SundayRosin/RunGenerator/README.md

<h1 align="center">Блок управления бензиновым генератором «Дозор», версия ПО 1.0.</h1>

<h2>Краткое описание.</h2>
<p align="left">
Блок управления предназначен для автоматического запуска генератора, в случае пропадания напряжения в городской сети.
</p>
<p>
Проект был разработан в 2021 году.
</p>
<p>
<a href="./Docs/Boards/Boards.md">Описание плат</a><br>
</p>
<p>
<a href="./Boards">Шаблоны плат (файлы sprint-layout 6)</a>
</p>
<p>
<a href="./Docs/Инструкция.docx">Инструкция и описание работы (Word file, 12 страниц)</a>
</p>
<p>
<a href="./Docs/LoadFirmware/LoadFirmware.md">Как прошить.</a>
</p>

<p align="left">
Устройство состоит из:<br>
-Плата «Blue Pill» с микроконтроллером  STM32F103C8T6.  Для быстрого обновления управляющей программы, микроконтроллер прошит загрузчиком arduino stm32 bootloader.  Написана программа, позволяющая удаленно обновлять прошивку (без наличия средств разработки).<br>
-Плата периферии. Содержит элементы управления и выходные каскады.
</p>
<p>
Программа для микроконтроллера написана на языке C, в среде разработки Keil uVision5.
</p>
<p>
 
</p>

Инструкция находиться в папке Firmware/Doc.<br>
Так же написанна программа FirmwareUpdater на Qt для удаленной прошивки устройства.
</p>
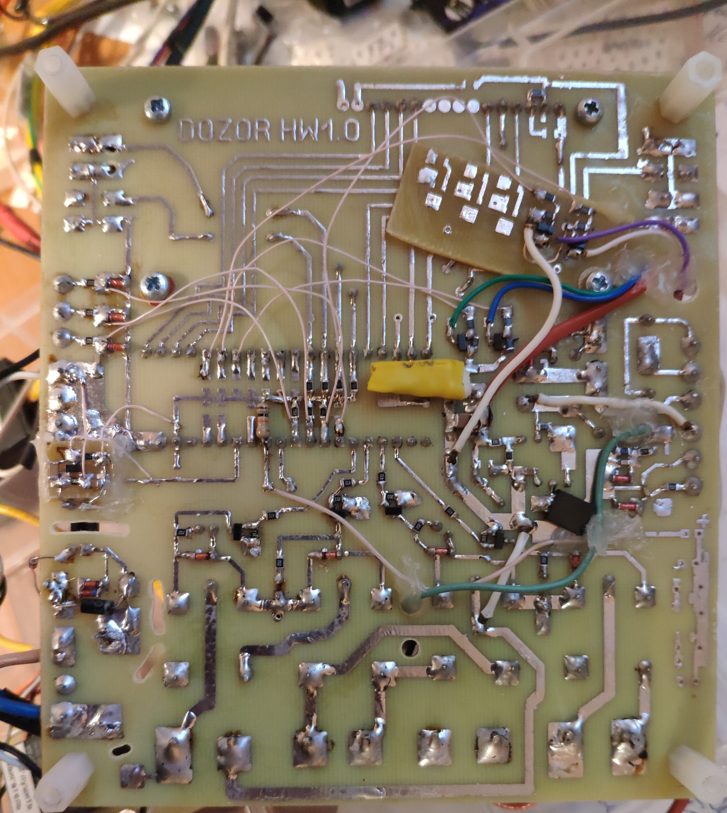
[picture p1: Фото устройства/IMG_20210401_210557.jpg]

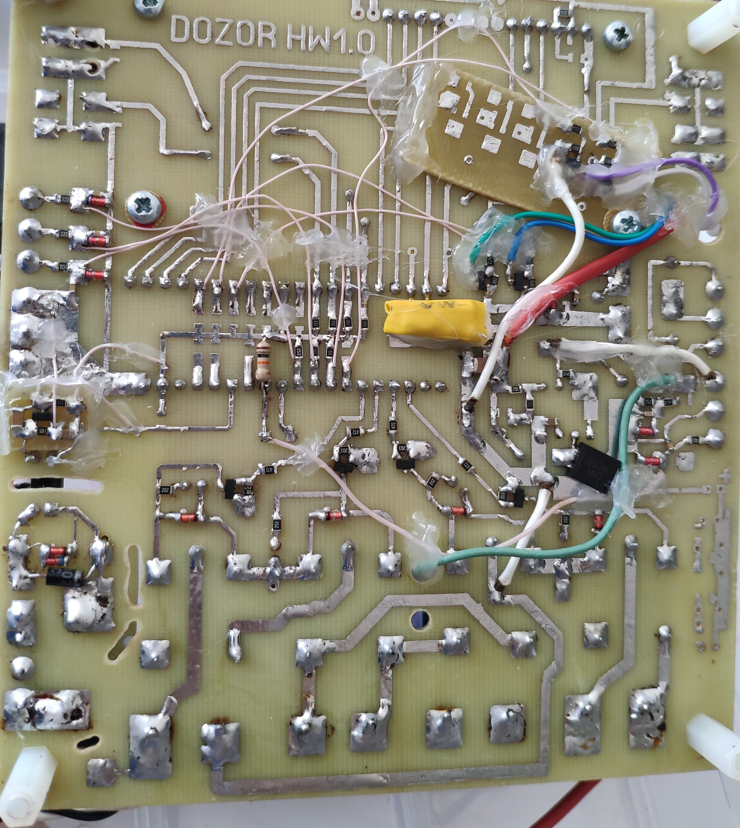
[picture p2: Фото устройства/IMG_20210402_081232.jpg]

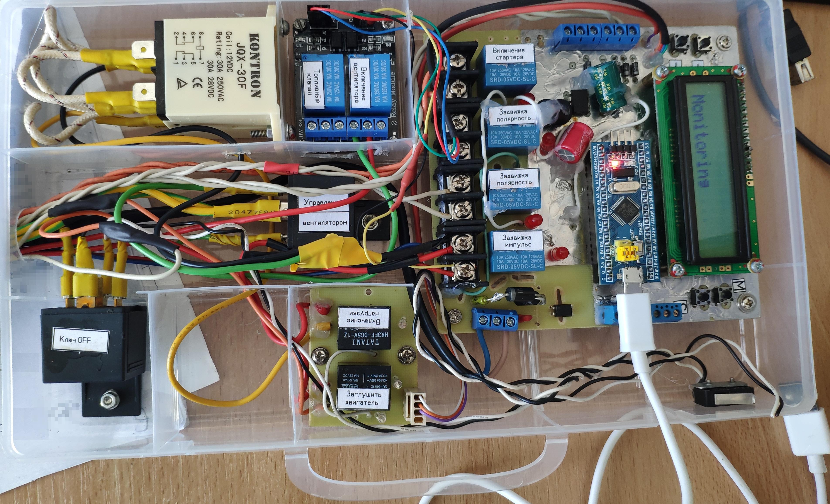
[picture p3: Фото устройства/IMG_20210402_120038.jpg]

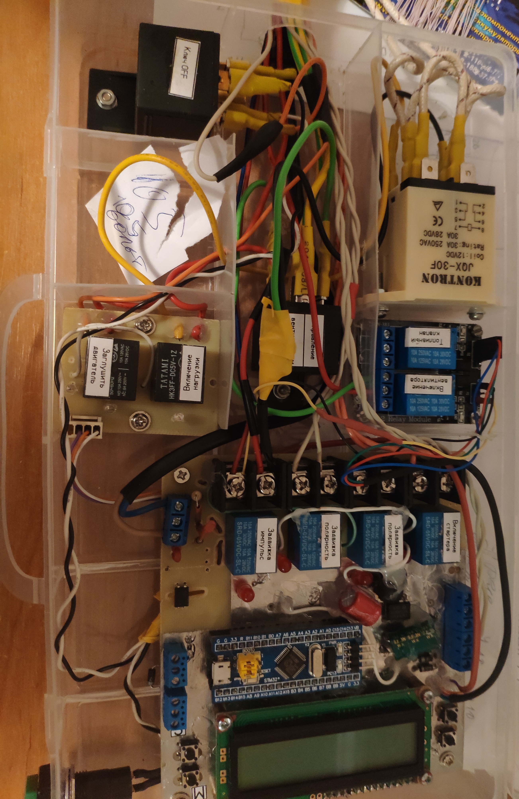
[picture p4: Фото устройства/IMG_20210402_212343.jpg]
