SundayRosin/RunGenerator/Docs/HowLoadFirmware.md

<h2>Сборка и загрузка прошивки.</h2>
<p>
Устанавливаем Keil v5.36. Даем скачать все пакеты. Перезагружаемся.<br>
Открываем STM32ControlBoard.uvprojx и убеждаемся что в узле «AfterMake» указан правильный путь к каталогу Keil.<br>
Открываем проект, собираем прошивку(F7). Если просит установить дополнительный пакет – разрешаем. После установки перезапускаем программу. 
</p>
<p>
Для загрузки прошивки в формате .bin используем стандартную программу от Arduino IDE. Качаем STM32 ядро для Arduino.
Проверена работоспособность ядра на Arduino IDE версии 1.6.9.
Скачать можно из https://github.com/rogerclarkmelbourne/Arduino_STM32<br>
Потребуется только файлы в каталоге Arduino_STM32\tools\win\ , остальное можно удалить.
</p>
<p>
Качаем и устанавливаем библиотеки java (файл JavaSetup8u371.exe). Перезагружаемся.
</p>
<p>
Открываем консоль и вводим «java -version». Должны получить установленную версию.
</p>
<p>
Устанавливаем драйвер MapleDriver\install_drivers.bat
</p>
<p>
Подключаем плату. Если загрузчик прошит  - будет мигать синим светодиодом.<br>
Идем в диспетчер устройств и выясняем на каком порту определилась плата.<br>
Задаем правильный путь в loadFw.bat.<br>
Открываем командную консоль, вводим путь к loadFw.bat. Запускаем файл. Нажимаем reset на плате.<br>
</p>
