SundayRosin/RunGenerator/Docs/BootLoader/BootLoader.md

<h2>Как прошить загрузчик на плату.</h2>
<p>
Из проекта github.com/rogerclarkmelbourne/STM32duino-bootloader/tree/master/binaries
скачиваем файл generic_boot20_pc13.bin. 
<a href="../LoadFirmware/LoadFirmware.md">Прошиваем согласно инструкции.</a><br>
Или берем из \Binaries\ArduinoBootLoader.zip
</p>
