SundayRosin/RunGenerator/Docs/Boards/Boards.md

<h2 align="center">Печатные платы</h2>
<p>
Устройство собрано на печатных платах, изготовленных методом ЛУТ (лазерно-утюжная технология). Для печати шаблонов использована термотрансферная бумага. Дефекты при переводе рисунков подправлены лаком.
</p>
<p>
Все платы изготовлены из текстолита толщиной 1,5мм.
</p>
<p>
Основная плата изготовлена из двухстороннего текстолита.
</p>
<p>
В процессе доработки устройства пришлось сделать две дополнительные платы на которых установлены ключи управляющие реле, и плата повторителя датчика напряжения городской сети. 
</p>
<p>
На рисунках показаны шаблоны плат. Файлы находятся в папке Boards.
</p>
<p>
Основная плата (115 x 125 мм)<br>
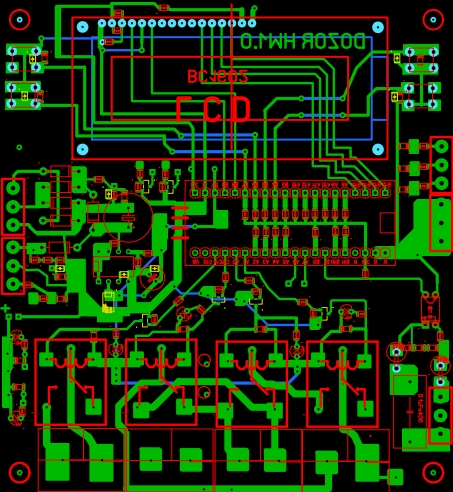
[picture p12: Docs/Boards/mainBoard.JPG]

</p>
<p>
Плата управления реле (50 x 40 мм)<br>
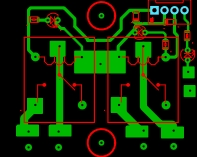
[picture p13: Docs/Boards/relayBoard.JPG]

</p>
<p>
Плата ключей (60 x 15 мм)<br>

</p>
<p>
Бирки для реле и кнопок<br>
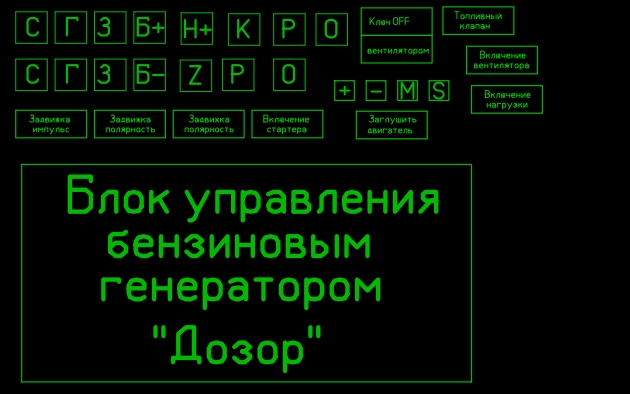
[picture p14: Docs/Boards/birki.JPG]

</p>
