SundayRosin/RunGenerator/Docs/Images/gen1.jpg

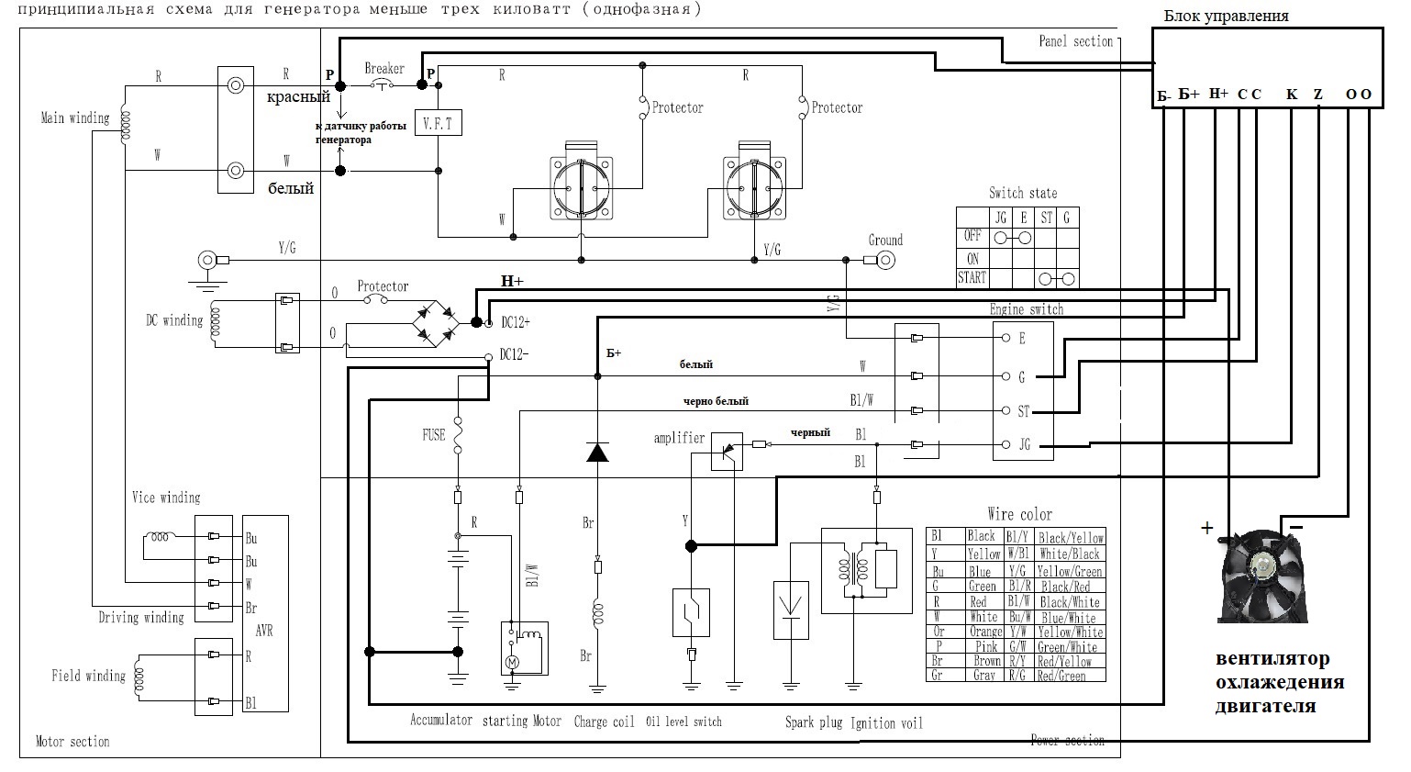
Docs/Images/gen1.jpg
