SundayRosin/RunGenerator/Docs/Images/gen2.jpg

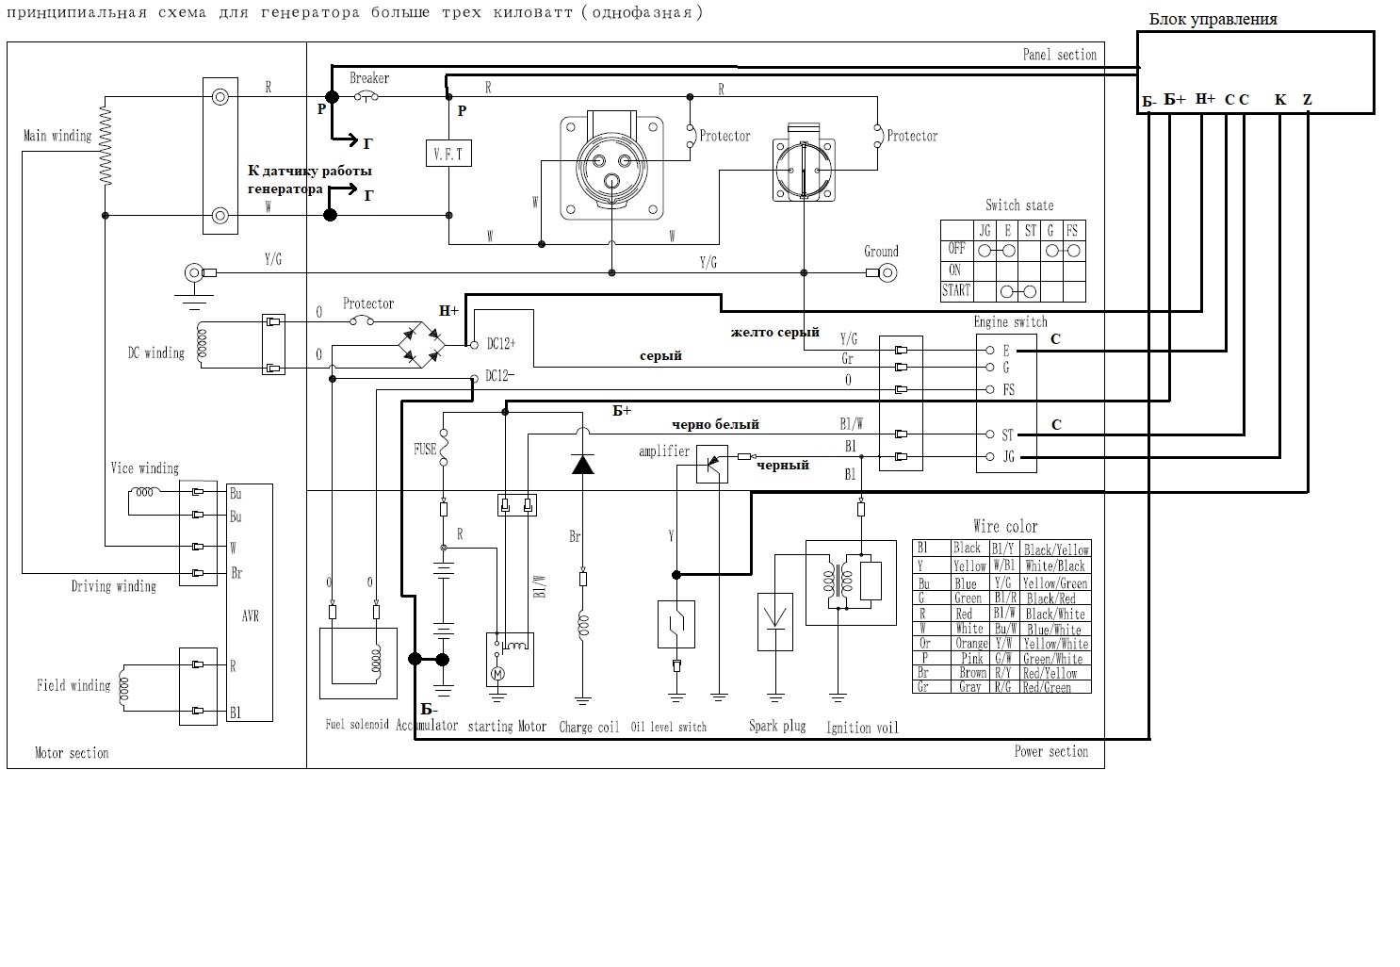
Docs/Images/gen2.jpg
