SundayRosin/RunGenerator/Docs/Images/Фото1.jpg

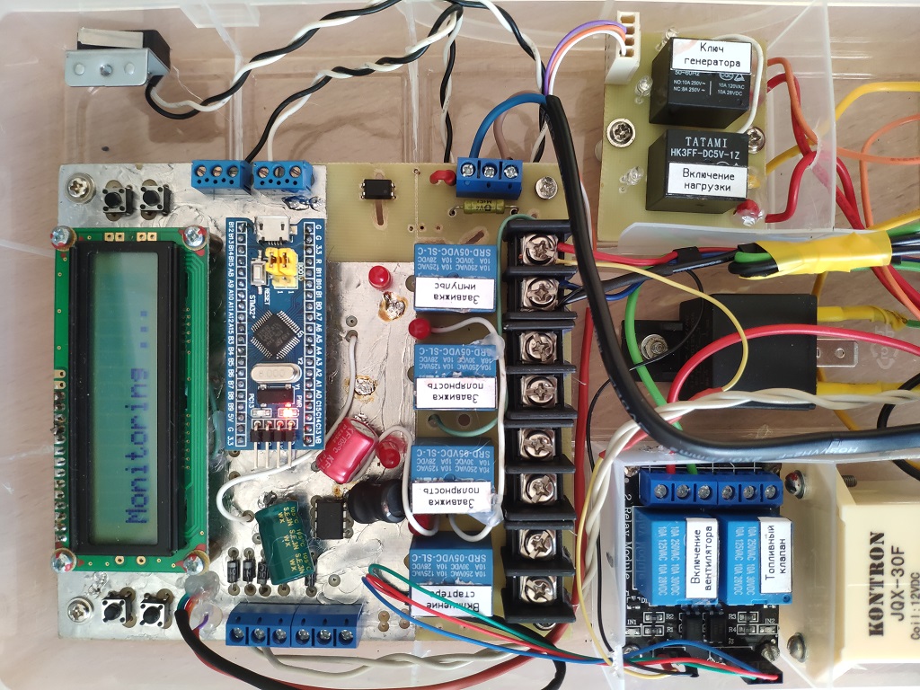
Docs/Images/Фото1.jpg
