SundayRosin/RunGenerator/Docs/Оптопара/220v-power-interface.jpg

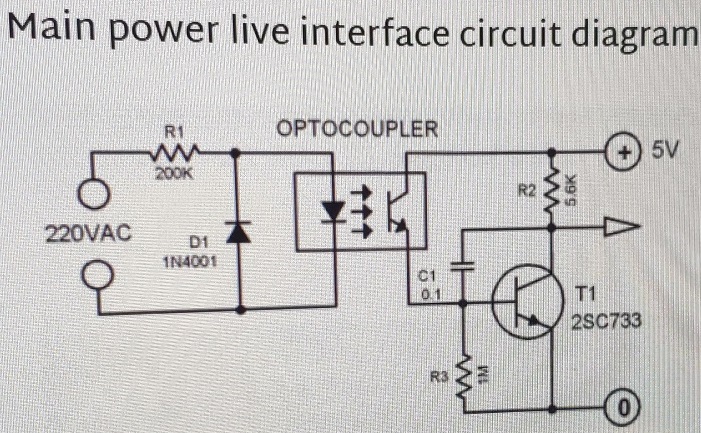
Docs/Оптопара/220v-power-interface.jpg
