SundayRosin/RunGenerator/Docs/Оптопара/220v_sensor.jpg

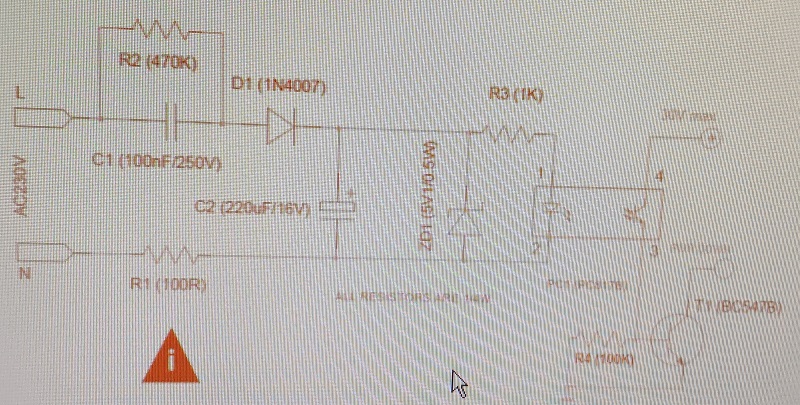
Docs/Оптопара/220v_sensor.jpg
