SundayRosin/RunGenerator/Source/FirmwareUpdater/FirmwareUpdater/Image/flash.png

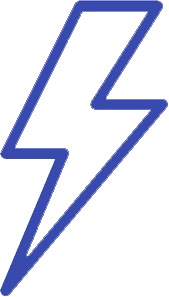
Source/FirmwareUpdater/FirmwareUpdater/Image/flash.png
