SundayRosin/RunGenerator/Фото устройства/IMG_20210327_091343.jpg

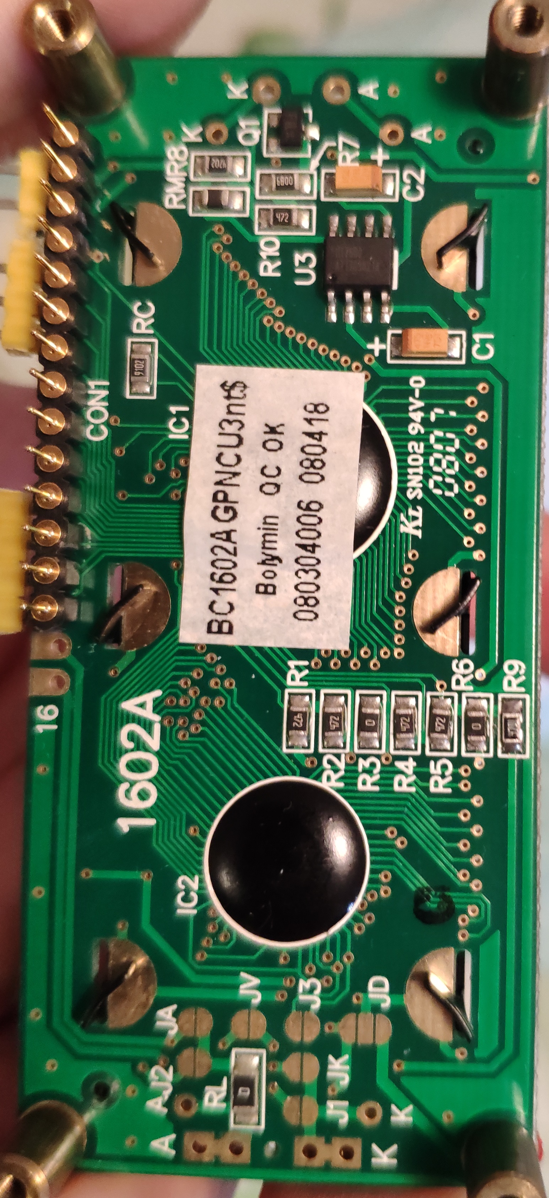
Фото устройства/IMG_20210327_091343.jpg
