SundayRosin/RunGenerator/Фото устройства/IMG_20210401_210558.jpg

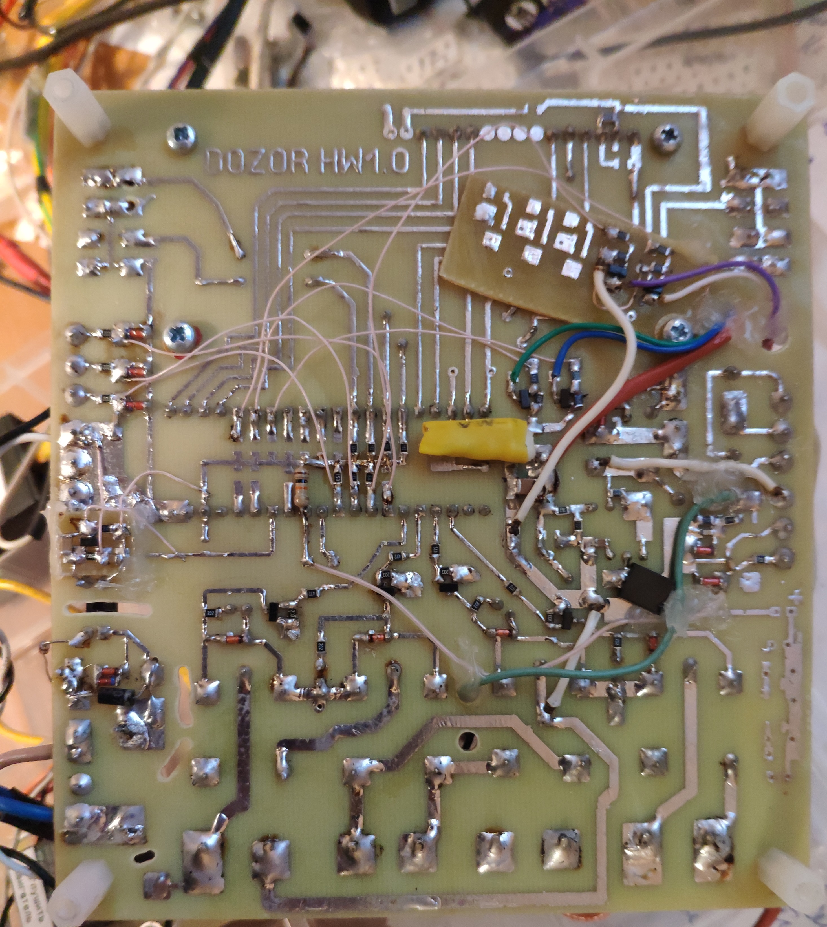
Фото устройства/IMG_20210401_210558.jpg
