SundayRosin/RunGenerator/(list of files, drawings)

Other design files:
Boards/birki.lay6
Boards/mainBoard.lay6
Boards/relayBoard.lay6
Boards/transistorsBoard.lay6
